4516N41/IC-Tester/(commit log)

2022-10-06 Solving problems with different screens
    [Flow.ino, IC_Tester.ino]
2022-10-30 Added a Delete Button
